Len42/Dexy/README.md

# Dexy

_DX7-inspired FM synthesis with a Raspberry Pi Pico_

Dexy is a digital FM voice in a 10 HP module. Part of my [homebrew Eurorack synthesizer](https://lenp.net/synth/).

[See here](https://lenp.net/synth/dexy/) for more info.

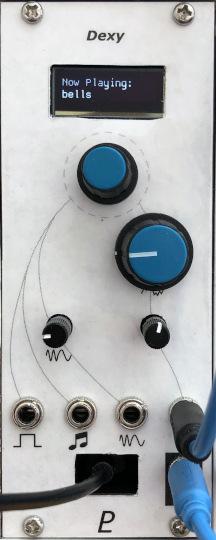
[picture p1: Dexy.jpg]
