Len42/Dexy/hardware/README.md

# Dexy Hardware

Dexy is a digital FM voice module based on an [RP2040 microcontroller](https://www.raspberrypi.com/documentation/microcontrollers/rp2040.html).

[See here](https://lenp.net/synth/dexy/hardware.html) for more info.

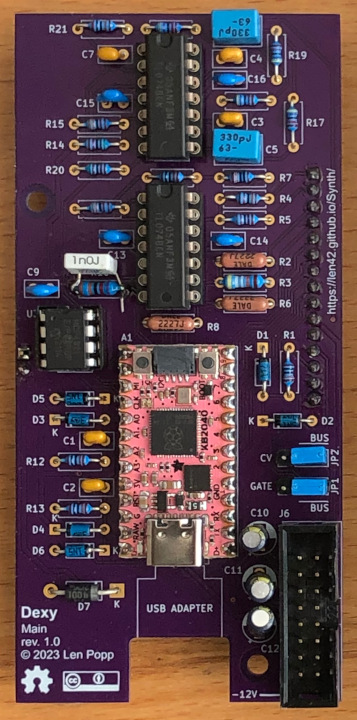
[picture p2: hardware/board.jpg]

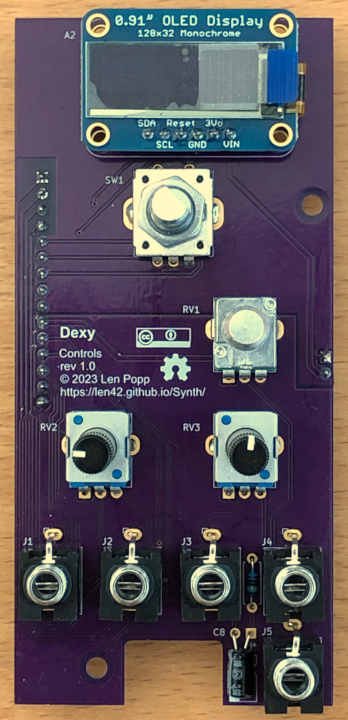
[picture p3: hardware/board2.jpg]
