Len42/Dexy/firmware/README.md

# Dexy Firmware

Firmware for the Dexy FM voice module.

[See here](https://lenp.net/synth/dexy/firmware.html) for more info.

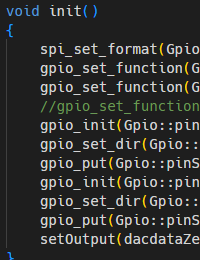
[picture p4: firmware/firmware.png]
