Len42/Dexy/software/DexyPatch/README.md

# DexyPatch Software

DexyPatch is a Windows application for editing patches for the Dexy module.

[See here](https://lenp.net/synth/dexy/software.html) for more info.

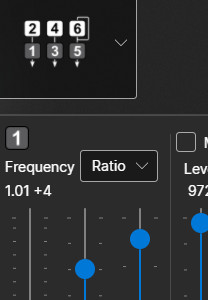
[picture p5: software/DexyPatch/software.jpg]
