Len42/Dexy/software/ConvertAlgoData/README.md

# ConvertAlgoData

This is a utility program to convert the definitions of the DX7 FM synthesis
algorithms from C++ (for the firmware) to C# (for the DexyPatch software).

<hr /><div><div style="xfloat:left; padding-left:10px;"><br />© 2023 Len Popp CC BY<br />This work is licensed under a <a rel="license" href="http://creativecommons.org/licenses/by/4.0/">Creative Commons Attribution 4.0 International License</a>.</div></div>
