Len42/Dexy/hardware/schematic2.png

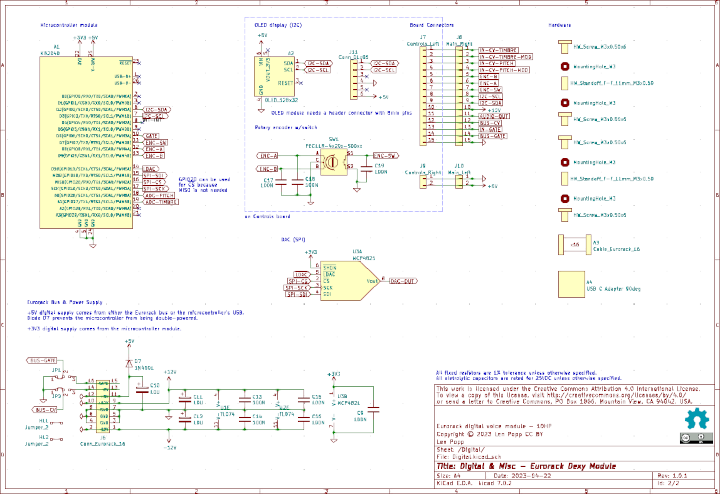
hardware/schematic2.png
