Len42/Dexy/hardware/schematic.png

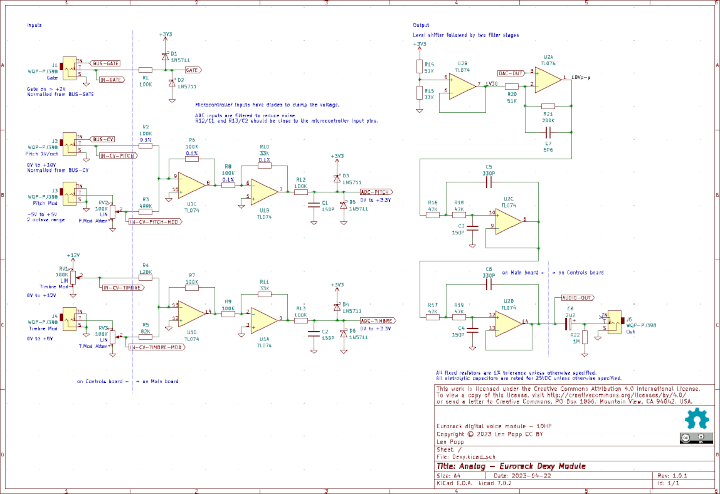
hardware/schematic.png
