Len42/Dexy/software/DexyPatch/DexyPatch/Assets/algorithms/algo-1.png

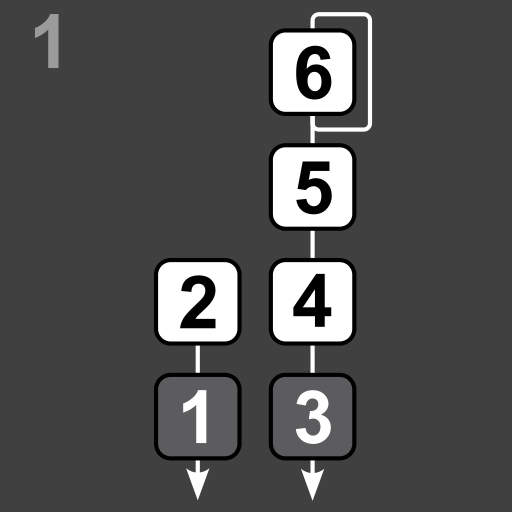
software/DexyPatch/DexyPatch/Assets/algorithms/algo-1.png
