Len42/Dexy/software/DexyPatch/DexyPatch/Assets/algorithms/algo-3.png

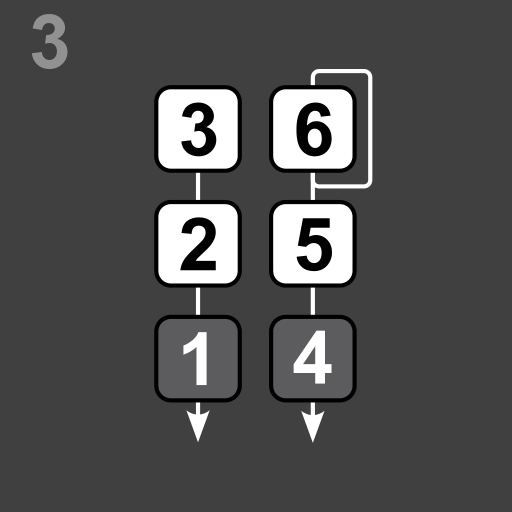
software/DexyPatch/DexyPatch/Assets/algorithms/algo-3.png
