Len42/Dexy/software/DexyPatch/DexyPatch/Assets/algorithms/algo-5.png

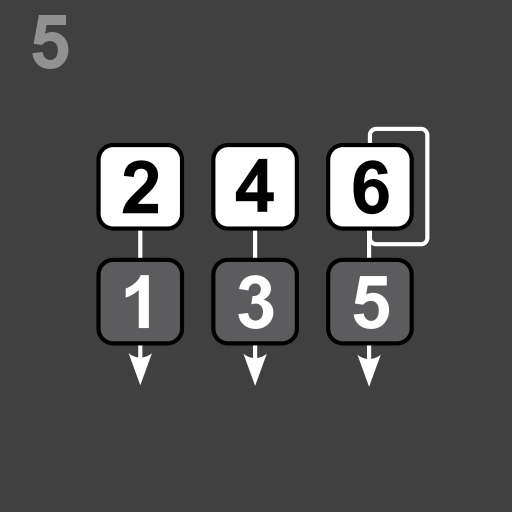
software/DexyPatch/DexyPatch/Assets/algorithms/algo-5.png
