Len42/Dexy/software/DexyPatch/DexyPatch/Assets/algorithms/algo-7.png

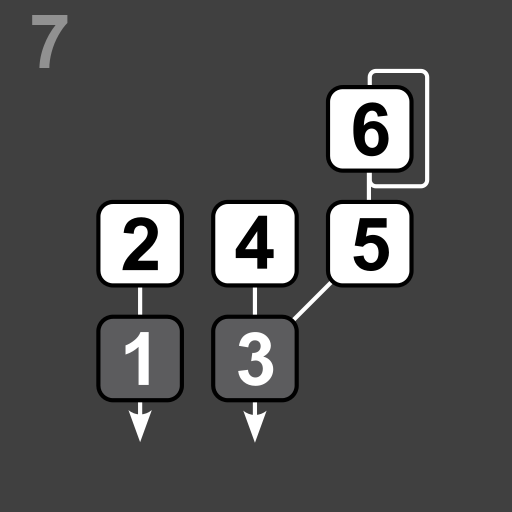
software/DexyPatch/DexyPatch/Assets/algorithms/algo-7.png
