Len42/Dexy/software/DexyPatch/DexyPatch/Assets/algorithms/algo-10.png

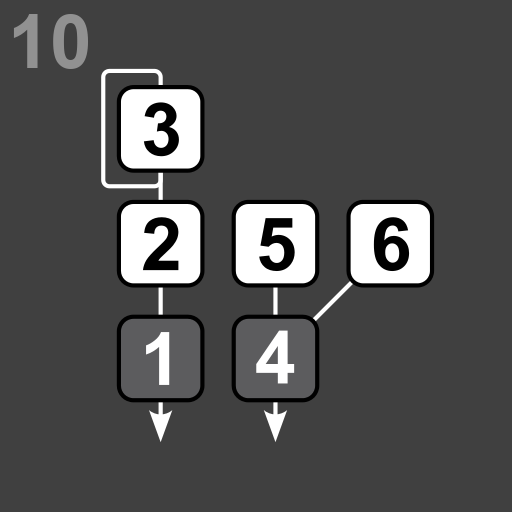
software/DexyPatch/DexyPatch/Assets/algorithms/algo-10.png
