Len42/Dexy/software/DexyPatch/DexyPatch/Assets/algorithms/algo-11.png

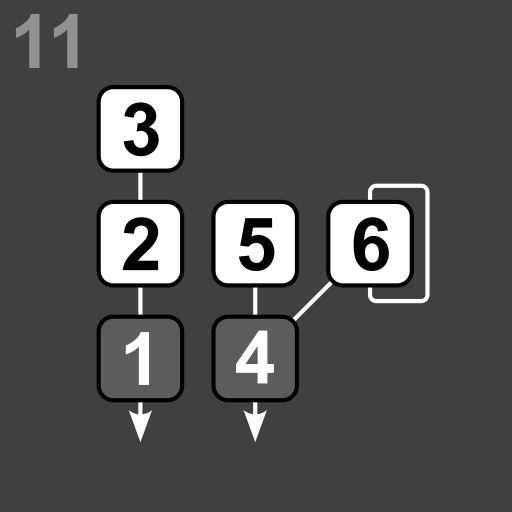
software/DexyPatch/DexyPatch/Assets/algorithms/algo-11.png
