Len42/Dexy/software/DexyPatch/DexyPatch/Assets/algorithms/algo-12.png

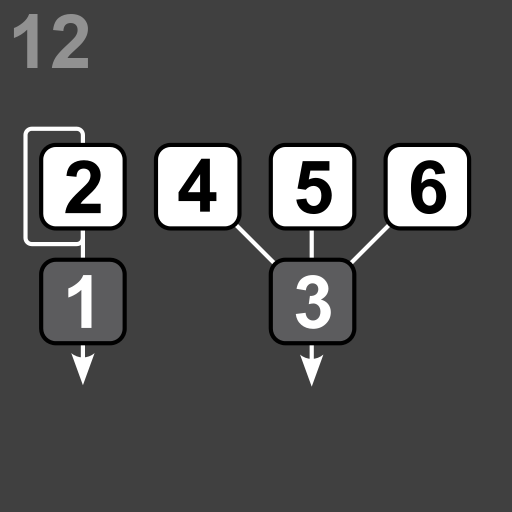
software/DexyPatch/DexyPatch/Assets/algorithms/algo-12.png
