Len42/Dexy/software/DexyPatch/DexyPatch/Assets/algorithms/algo-16.png

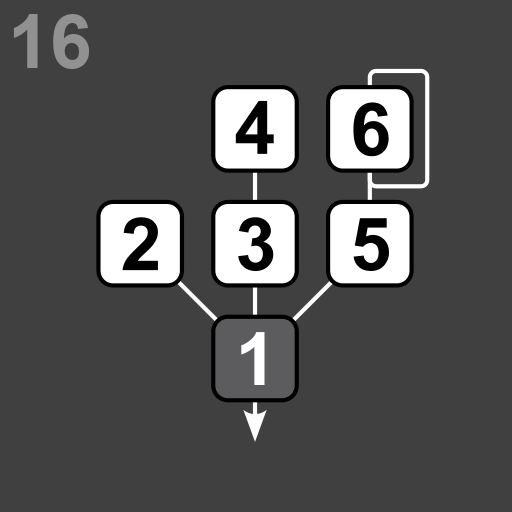
software/DexyPatch/DexyPatch/Assets/algorithms/algo-16.png
