Len42/Dexy/software/DexyPatch/DexyPatch/Assets/algorithms/algo-18.png

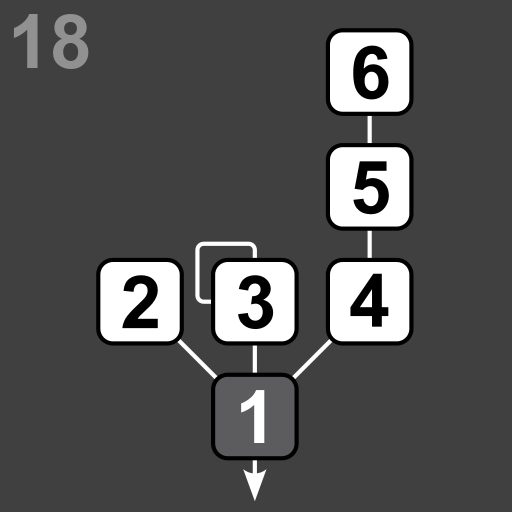
software/DexyPatch/DexyPatch/Assets/algorithms/algo-18.png
