Len42/Dexy/software/DexyPatch/DexyPatch/Assets/algorithms/algo-19.png

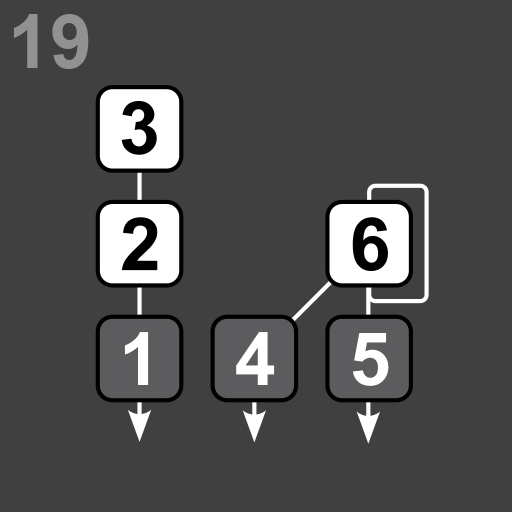
software/DexyPatch/DexyPatch/Assets/algorithms/algo-19.png
