Len42/Dexy/software/DexyPatch/DexyPatch/Assets/algorithms/algo-21.png

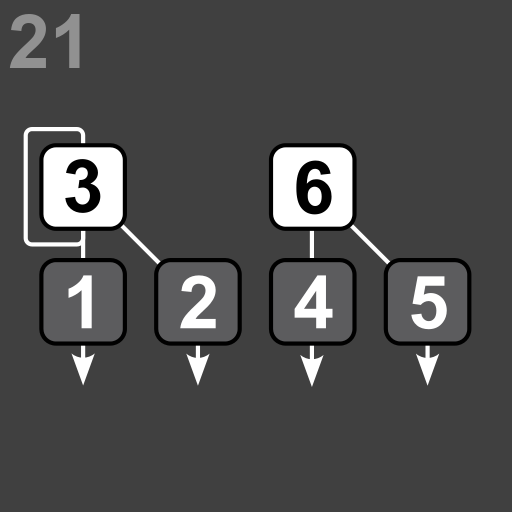
software/DexyPatch/DexyPatch/Assets/algorithms/algo-21.png
