Len42/Dexy/software/DexyPatch/DexyPatch/Assets/algorithms/algo-23.png

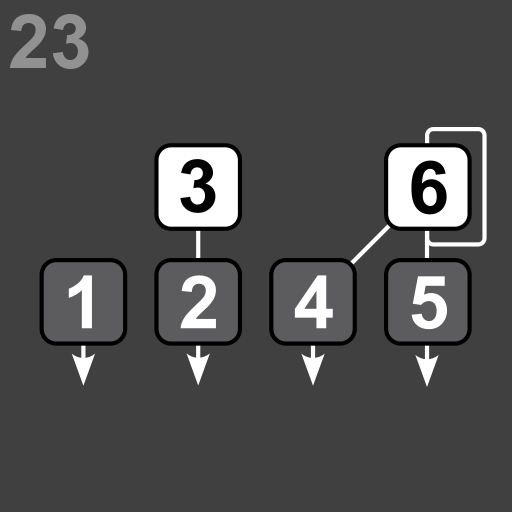
software/DexyPatch/DexyPatch/Assets/algorithms/algo-23.png
