Len42/Dexy/software/DexyPatch/DexyPatch/Assets/algorithms/algo-24.png

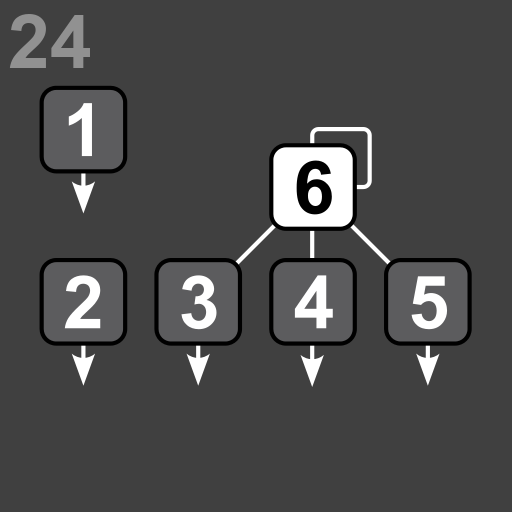
software/DexyPatch/DexyPatch/Assets/algorithms/algo-24.png
