Len42/Dexy/software/DexyPatch/DexyPatch/Assets/algorithms/algo-25.png

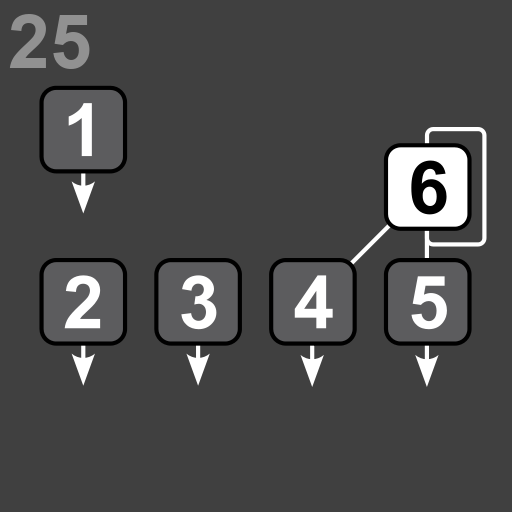
software/DexyPatch/DexyPatch/Assets/algorithms/algo-25.png
