Len42/Dexy/software/DexyPatch/DexyPatch/Assets/algorithms/algo-26.png

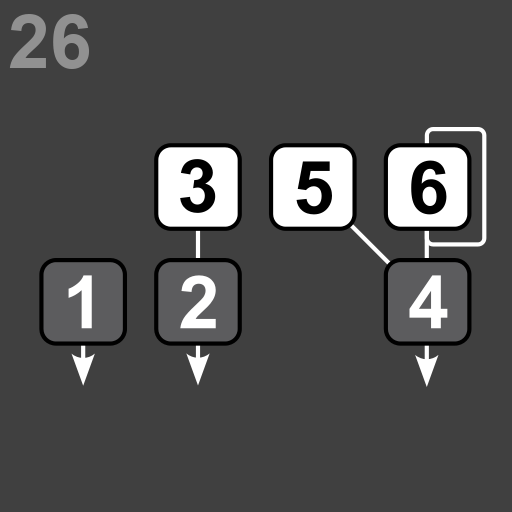
software/DexyPatch/DexyPatch/Assets/algorithms/algo-26.png
