Len42/Dexy/software/DexyPatch/DexyPatch/Assets/algorithms/algo-28.png

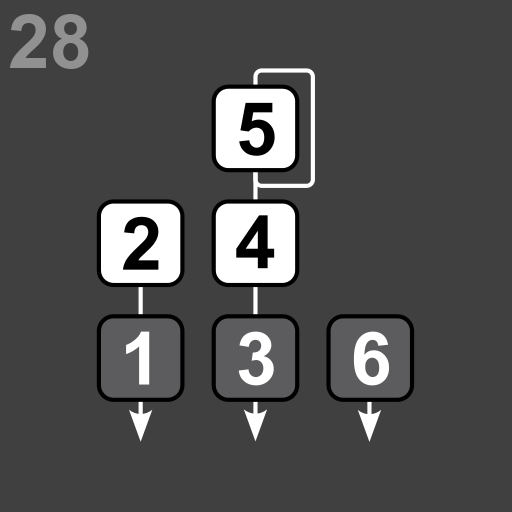
software/DexyPatch/DexyPatch/Assets/algorithms/algo-28.png
