Len42/Dexy/software/DexyPatch/DexyPatch/Assets/algorithms/algo-29.png

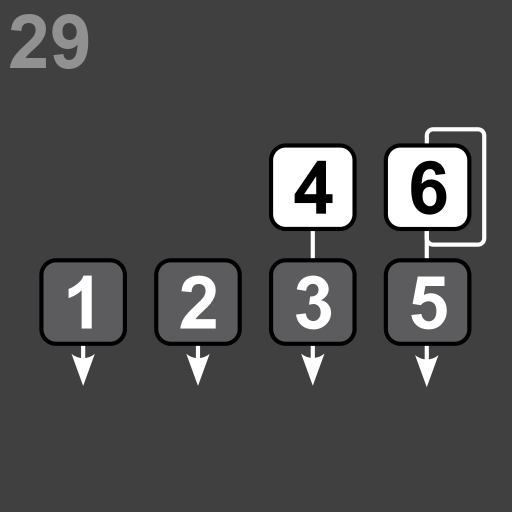
software/DexyPatch/DexyPatch/Assets/algorithms/algo-29.png
