Len42/Dexy/software/DexyPatch/DexyPatch/Assets/algorithms/algo-30.png

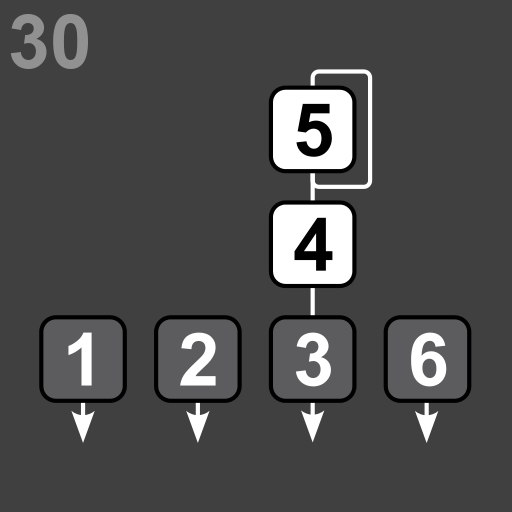
software/DexyPatch/DexyPatch/Assets/algorithms/algo-30.png
