Len42/Dexy/software/DexyPatch/DexyPatch/Assets/algorithms/algo-31.png

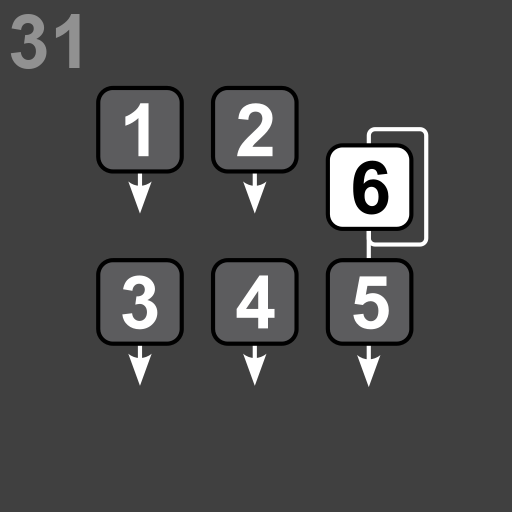
software/DexyPatch/DexyPatch/Assets/algorithms/algo-31.png
