Len42/Dexy/software/DexyPatch/screen.jpg

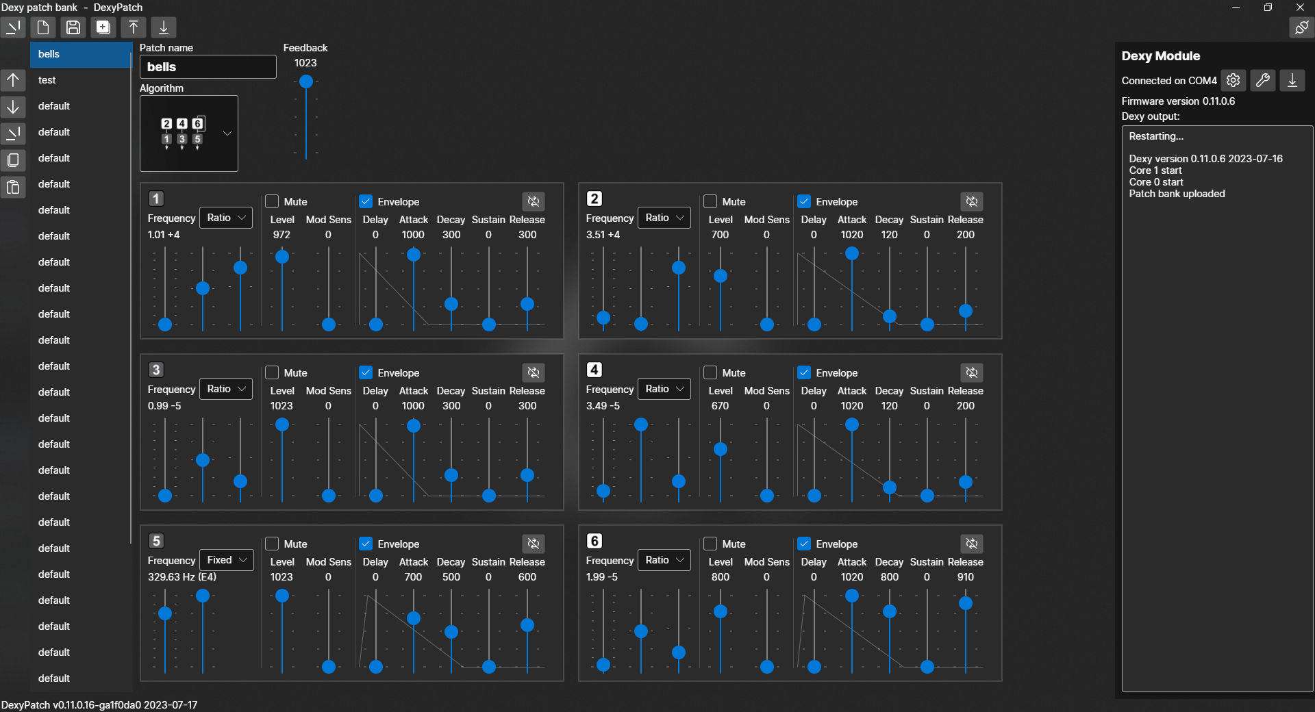
software/DexyPatch/screen.jpg
