Len42/Dexy/hardware/schematic.pdf

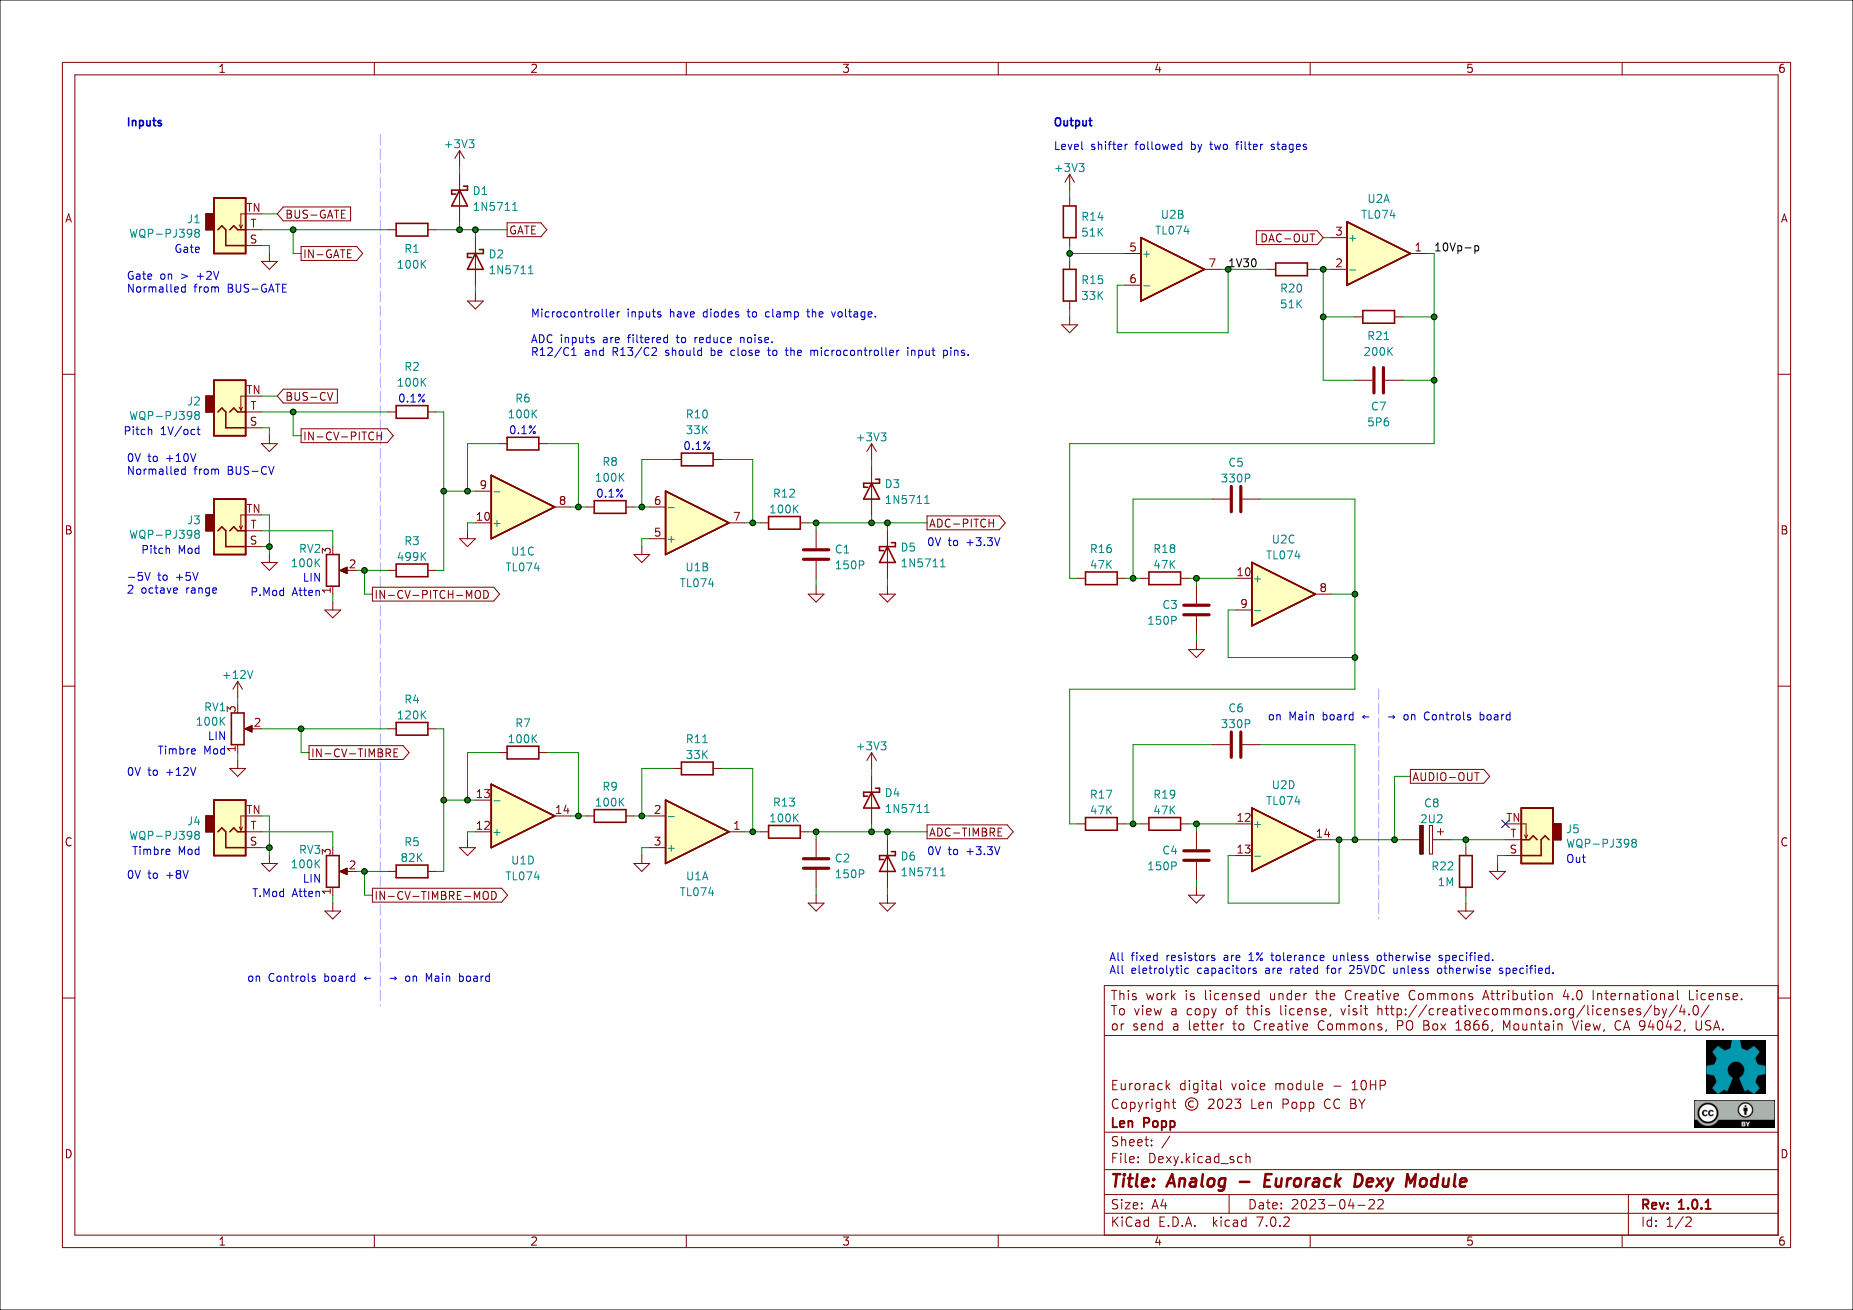
[picture p28: page 1]

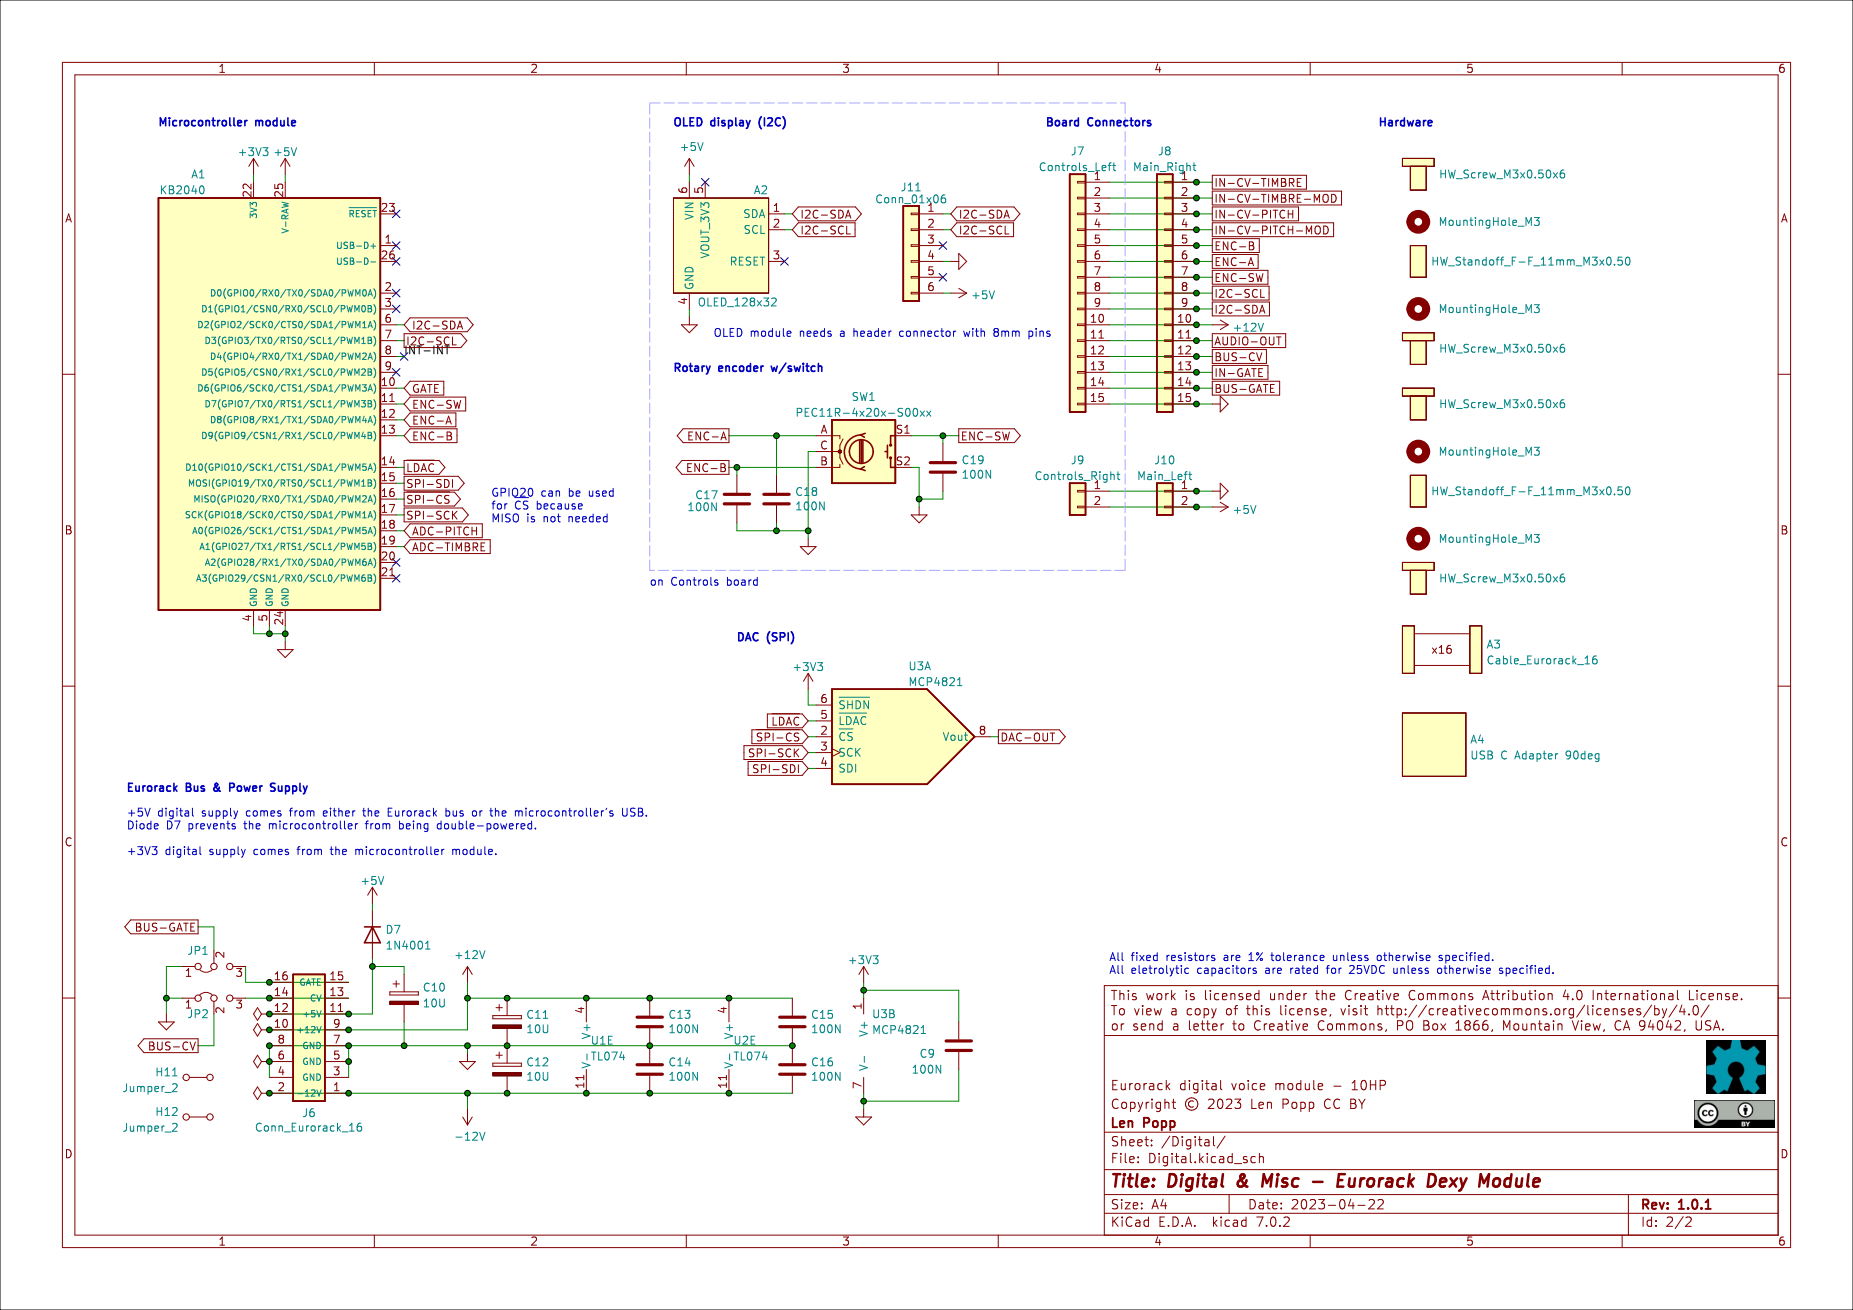
[picture p29: page 2]
