Len42/Dexy/hardware/Dexy.kicad_pcb

## KiCad design hardware/Dexy.kicad_pcb (2024-08-08)

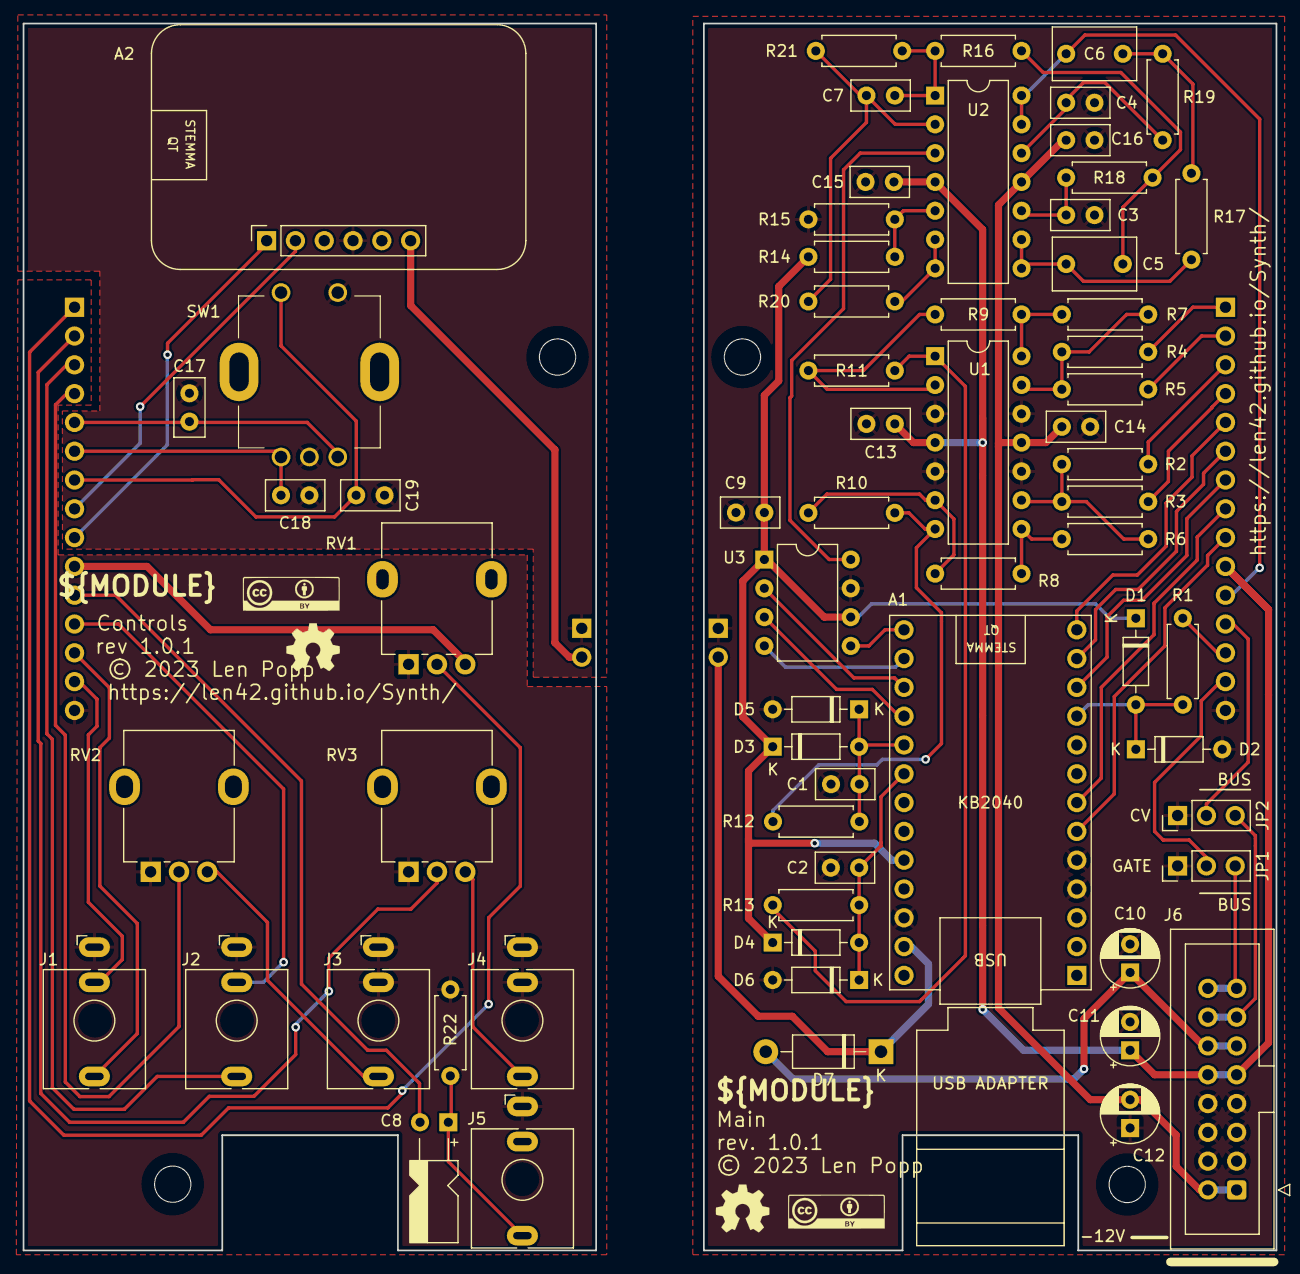
[picture p30: board Dexy.kicad_pcb from above]

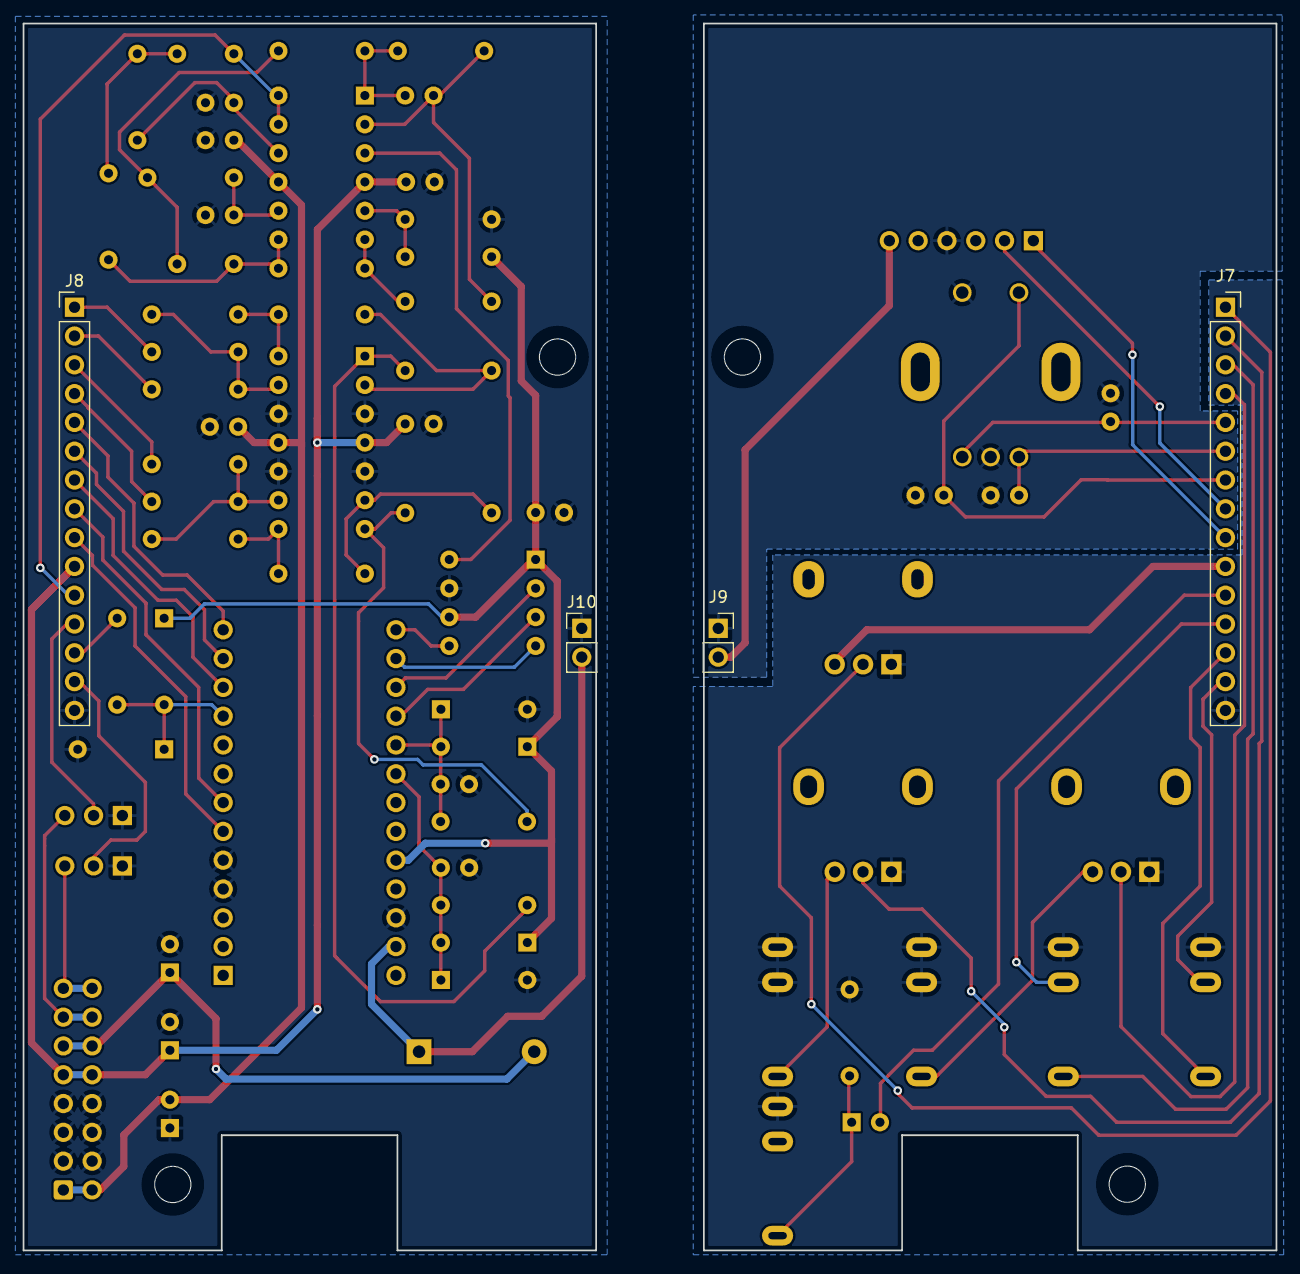
[picture p31: board Dexy.kicad_pcb from below]

Board: 2 copper layers, 110.5 x 108.2 mm, 78 parts (4 on the bottom side), 49 nets.

Parts:
A1: KB2040
A2: OLED_128x32; OLED_128x32_0.91in_NoHoles
A4: USB C Adapter 90deg; USB-C-Adapter-90-Outline
C1, C2, C3, C4: 150P; C_Disc_D5.0mm_W2.5mm_P2.50mm
C5, C6: 330P; C_Rect_L7.2mm_W4.5mm_P5.00mm
C7: 5P6; C_Disc_D5.0mm_W2.5mm_P2.50mm
C8: 2U2; CP_Radial_L7.0mm_D4.0mm_P2.50mm_Horiz
C9, C13, C14, C15, C16, C17, C18, C19: 100N; C_Disc_D5.0mm_W2.5mm_P2.50mm
C10, C11, C12: 10U; CP_Radial_D5.0mm_P2.50mm
D1, D2, D3, D4, D5, D6: 1N5711; D_DO-35_SOD27_P7.62mm_Horizontal
D7: 1N4001; D_DO-41_SOD81_P10.16mm_Horizontal
G1, G2: LOGO; Logo_CC_BY
G3, G4: LOGO; Logo_OSHW
H1, H2, H3, H4: MountingHole_M3; MountingHole_PCB_3.2mm_M3
J1, J2, J3, J4, J5: WQP-PJ398; Jack_3.5mm_QingPu_WQP-PJ398SM_Vertical
J6: Conn_Eurorack_16; IDC-Header-Eurorack-16-TH
J7: Controls_Left; PinSocket_1x15_P2.54mm_Vertical
J8: Main_Right; PinHeader_1x15_P2.54mm_Vertical
J9: Controls_Right; PinSocket_1x02_P2.54mm_Vertical
J10: Main_Left; PinHeader_1x02_P2.54mm_Vertical
JP1, JP2: Jumper_Pins_3_Bridged12; PinHeader_1x03_P2.54mm_Vertical
R1, R2, R6, R7, R8, R9, R12, R13: 100K; R_Axial_DIN0207_L6.3mm_D2.5mm_P7.62mm_Horizontal
R3: 499K; R_Axial_DIN0207_L6.3mm_D2.5mm_P7.62mm_Horizontal
R4: 120K; R_Axial_DIN0207_L6.3mm_D2.5mm_P7.62mm_Horizontal
R5: 82K; R_Axial_DIN0207_L6.3mm_D2.5mm_P7.62mm_Horizontal
R10, R11, R15: 33K; R_Axial_DIN0207_L6.3mm_D2.5mm_P7.62mm_Horizontal
R14, R20: 51K; R_Axial_DIN0207_L6.3mm_D2.5mm_P7.62mm_Horizontal
R16, R17, R18, R19: 47K; R_Axial_DIN0207_L6.3mm_D2.5mm_P7.62mm_Horizontal
R21: 200K; R_Axial_DIN0207_L6.3mm_D2.5mm_P7.62mm_Horizontal
R22: 1M; R_Axial_DIN0207_L6.3mm_D2.5mm_P7.62mm_Horizontal
RV1: 100K; Potentiometer_Alpha_RD901F-40-00D_Single_Vertical
RV2, RV3: 100K; Potentiometer_SongHuei_Single_Vertical
SW1: PEC11R-4x20x-S00xx; Encoder_Bourns_PEC11R_Switch
U1, U2: TL074; DIP-14_W7.62mm
U3: MCP4821; DIP-8_W7.62mm

Connections:
+3V3: A1.22 (3V3), C9.2, D1.1 (K), D3.1 (K), D4.1 (K), R14.1, U3.1 (V+), U3.6 (~SHDN)
+5V: A1.25 (V-RAW), A2.6 (VIN), D7.1 (K), J9.2, J10.2
+12V: C11.1, C13.1, C15.1, J6.9 (+12V), J6.10, J7.10, J8.10, RV1.3, U1.4 (V+), U2.4 (V+)
-12V: C12.2, C14.2, C16.2, J6.1 (-12V), J6.2, U1.11 (V-), U2.11 (V-)
/1V30: R20.1, U2.6 (-), U2.7
/10Vp-p: C7.2, R16.1, R21.2, U2.1
ADC-PITCH: A1.18 (A0(GPIO26/SCK1/CTS1/SDA1/PWM5A)), C1.1, D3.2 (A), D5.1 (K), R12.2
ADC-TIMBRE: A1.19 (A1(GPIO27/TX1/RTS1/SCL1/PWM5B)), C2.1, D4.2 (A), D6.1 (K), R13.2
AUDIO-OUT: C6.2, C8.2, J7.11, J8.11, U2.13 (-), U2.14
BUS-CV: J2.TN, J7.12, J8.12, JP2.2 (C)
BUS-GATE: J1.TN, J7.14, J8.14, JP1.2 (C)
DAC-OUT: U2.3 (+), U3.8 (Vout)
ENC-A: A1.12 (D8(GPIO8/RX1/TX1/SDA0/PWM4A)), C18.1, J7.6, J8.6, SW1.A
ENC-B: A1.13 (D9(GPIO9/CSN1/RX1/SCL0/PWM4B)), C17.1, J7.5, J8.5, SW1.B
ENC-SW: A1.11 (D7(GPIO7/TX0/RTS1/SCL1/PWM3B)), C19.1, J7.7, J8.7, SW1.S1
GATE: A1.10 (D6(GPIO6/SCK0/CTS1/SDA1/PWM3A)), D1.2 (A), D2.1 (K), R1.2
GND: A1.4 (GND), A1.5 (GND), A1.24 (GND), A2.4 (GND), C1.2, C2.2, C3.2, C4.2, C9.1, C10.2, C11.2, C12.1, C13.2, C14.1, C15.2, C16.1, C17.2, C18.2, C19.2, D2.2 (A), D5.2 (A), D6.2 (A), J1.S, J2.S, J3.S, J3.TN, J4.S, J4.TN, J5.S, J6.3 (GND), J6.4, J6.5 (GND), J6.6, J6.7 (GND), J6.8, J7.15, J8.15, J9.1, J10.1, JP1.1 (A), JP2.1 (A), R15.2, R22.2, RV1.1, RV2.1, RV3.1, SW1.C, SW1.S2, U1.3 (+), U1.5 (+), U1.10 (+), U1.12 (+), U3.7 (V-)
I2C-SCL: A1.7 (D3(GPIO3/TX0/RTS0/SCL1/PWM1B)), A2.2 (SCL), J7.8, J8.8
I2C-SDA: A1.6 (D2(GPIO2/SCK0/CTS0/SDA1/PWM1A)), A2.1 (SDA), J7.9, J8.9
IN-CV-PITCH: J2.T, J7.3, J8.3, R2.1
IN-CV-PITCH-MOD: J7.4, J8.4, R3.1, RV2.2
IN-CV-TIMBRE: J7.1, J8.1, R4.1, RV1.2
IN-CV-TIMBRE-MOD: J7.2, J8.2, R5.1, RV3.2
IN-GATE: J1.T, J7.13, J8.13, R1.1
unnamed: C5.1, R16.2, R18.1
unnamed: C6.1, R17.2, R19.1
unnamed: C8.1, J5.T, R22.1
unnamed: C10.1, D7.2 (A), J6.11 (+5V), J6.12
unnamed: J3.T, RV2.3
unnamed: J4.T, RV3.3
unnamed: J6.13 (CV), J6.14, JP2.3 (B)
unnamed: J6.15 (GATE), J6.16, JP1.3 (B)
unnamed: R6.2, R8.1, U1.8
unnamed: R7.2, R9.1, U1.14
unnamed: R10.2, R12.1, U1.7
unnamed: R11.2, R13.1, U1.1
unnamed: R9.2, R11.1, U1.2 (-)
unnamed: R8.2, R10.1, U1.6 (-)
unnamed: R2.2, R3.2, R6.1, U1.9 (-)
unnamed: R4.2, R5.2, R7.1, U1.13 (-)
unnamed: C7.1, R20.2, R21.1, U2.2 (-)
unnamed: R14.2, R15.1, U2.5 (+)
unnamed: C3.1, R18.2, U2.10 (+)
unnamed: C5.2, R17.1, U2.8, U2.9 (-)
unnamed: C4.1, R19.2, U2.12 (+)
SPI-SCK: A1.17 (SCK(GPIO18/SCK0/CTS0/SDA1/PWM1A)), U3.3 (SCK)
SPI-SDI: A1.15 (MOSI(GPIO19/TX0/RTS0/SCL1/PWM1B)), U3.4 (SDI)
~LDAC: A1.14 (D10(GPIO10/SCK1/CTS1/SDA1/PWM5A)), U3.5 (~LDAC)
~SPI-CS: A1.16 (MISO(GPIO20/RX0/TX1/SDA0/PWM2A)), U3.2 (~CS)
