Len42/Dexy/software/PatchDump/main.cpp

// PatchDump.cpp : This file contains the 'main' function. Program execution begins and ends there.
//

#include <iostream>
#include <fstream>
#include <string>
#include <string_view>
#include <format>
#include <vector>
#include <variant>
#include <ranges>
#include <concepts>
#include <exception>
#include <cmath>

// Definitions for CmdLine.h
//#define CMDLINE_PROG_NAME "patchdump"
#define CMDLINE_PROG_DESCRIPTION "Dump a Dexy patchbank file in text format"
#define CMDLINE_ALLOW_ARGS true
#define CMDLINE_ARGS_DESCRIPTION "Dexy patchbank file (default stdin)"
#define CMDLINE_OPTIONS(ITEM) \
    ITEM(ShowVersion, v, ver, bool, false, "Display the software version at startup") \
    ITEM(Debug, d, debug, bool, false, "Display debugging info")
#include "CmdLine.h"
#include "Banner.h"
#include "zpp_bits.h"

// header files from firmware
#include "Defs.h"
#include "Patches1.h"

using PatchBank = std::variant<Dexy::Patches::V1::PatchBank, /*DEBUG*/int>;

// Patch file header fields
using cookie_t = uint32_t;
constexpr cookie_t serializeCookie = 'D'|('e'|('x'|('y'<<8))<<8)<<8; // little-endian
using version_t = uint16_t;
constexpr version_t versionMax = 2; // DEBUG 1;
constexpr size_t serializeHdrSize = sizeof(serializeCookie) + sizeof(version_t);

// Maximum file size, based on the largest version of serialized patch data
constexpr size_t maxFileSize = serializeHdrSize + Dexy::Patches::V1::patchBankSize;

static std::string inputFileName;

// DPRINT - Print output only if the debug flag is set
#define DPRINT(msg, ...) \
    if (CommandLine::GetDebug()) { \
        std::cout << std::format(msg, __VA_ARGS__) << '\n'; \
    }

[[noreturn]] static void throwError(const char* message)
{
    throw std::runtime_error(message);
}

[[noreturn]] static void throwFileError(const char* message)
{
    throwError(std::format("{} {}", message, inputFileName).c_str());
}

static std::string_view TrimBlanks(std::string_view str)
{
    size_t start = str.find_first_not_of(" ");
    if (start == std::string_view::npos) {
        return std::string_view();
    } else {
        str.remove_prefix(start);
        size_t end = str.find_last_not_of(" ");
        if (end != std::string_view::npos) {
            str.remove_suffix(str.length() - end - 1);
        }
        return str;
    }
}

static auto ReadFile(std::istream& input)
{
    // Read one more byte than the max necessary, to check for eof.
    std::vector<char> storage(maxFileSize + 1);
    input.read(storage.data(), maxFileSize + 1);
    size_t numRead = input.gcount();
    DPRINT("ReadFile: numRead={}", numRead);
    if (numRead > maxFileSize) {
        throwFileError("Bad patch file length");
    }
    storage.resize(numRead);
    return storage;
}

static version_t CheckHeader(auto& in)
{
    cookie_t cookie;
    version_t version;
    in(cookie, version).or_throw();
    DPRINT("CheckHeader: cookie={:x} version={}", cookie, version);
    if (cookie != serializeCookie) {
        throwFileError("Bad patch file header");
    }
    if (version == 0 || version > versionMax) {
        throwFileError("Bad patch file version");
    }
    return version;
}

/// <summary>
/// Apply a function to each operator in a patch, in display order.
/// </summary>
/// <remarks>
/// Use this instead of a "for" loop because the display order for the operators
/// is the reverse of the storage order (for historical reasons).
/// </remarks>
template<class PATCH, class OP>
static void DoAllOps(std::ostream& output, const PATCH& patch, auto func)
{
    for (const OP& op : patch.opParams | std::views::reverse) {
        func(output, op);
    }
}

static auto LoadPatchBank(auto storage)
{
    try {
        PatchBank patchBank;
        zpp::bits::in in(storage);
        version_t version = CheckHeader(in);
        switch (version) {
        case 1:
            patchBank = Dexy::Patches::V1::PatchBank();
            in(std::get<Dexy::Patches::V1::PatchBank>(patchBank)).or_throw();
            break;
        case 2:
            patchBank = int();
            in(std::get<int>(patchBank)).or_throw();
            break;
        default:
            throwFileError("Unrecognized patchbank version");
        }
        DPRINT("LoadPatchBank: Read patchbank version={}", version);
        // There should be no data left in the file
        if (!in.remaining_data().empty()) {
            throwFileError("Bad patch file length");
        }
        return std::pair{ version, patchBank };
    } catch (std::system_error& ex) {
        // Improve the error messages from zpp::bits
        // TODO: don't format - just "Bad patch file contents" is fine
        std::string msg = std::format("Bad patch file contents ({}) -", ex.what());
        throwFileError(msg.c_str());
    }
}

template<class PATCH, class OP>
static void DumpOpField(std::ostream& output, const PATCH& patch,
                        std::string_view name, auto OP::* pfield)
{
    output << name;
    DoAllOps<PATCH, OP>(output, patch,
        [pfield](auto&& output, auto&& op)
            { output << std::format(",{}", op.*pfield); });
    output << '\n';
}

template<class PATCH, class OP, class SUB>
static void DumpOpField(std::ostream& output, const PATCH& patch,
                        std::string_view name, SUB OP::* psub, auto SUB::* pfield)
{
    output << name;
    DoAllOps<PATCH, OP>(output, patch,
        [pfield, psub](auto&& output, auto&& op)
            { output << std::format(",{}", op.*psub.*pfield); });
    output << '\n';
}

static std::string NoteToName(Dexy::midiNote_t midiNote)
{
    int noteNum = midiNote / 256;
    int frac = midiNote % 256;
    if (frac > 127) {
        ++noteNum;
        frac -= 256;
    } else if (frac < -127) {
        --noteNum;
        frac += 256;
    }
    int octave = noteNum / 12 - 1;
    int note = noteNum % 12;
    if (note < 0) {
        note += 12;
    }
    int cents = (int)((double)frac * 100 / Dexy::midiNoteSemitone);
    static constexpr std::string_view noteNames[] = {
      "C"sv,"C♯"sv,"D"sv,"E♭"sv,"E"sv,"F"sv,"F♯"sv,"G"sv,"G♯"sv,"A"sv,"B♭"sv,"B"sv
    };
    std::string_view noteName = noteNames[note];
    if (cents == 0) {
        return std::format("{}{}", noteName, octave);
    } else {
        return std::format("{}{}{:+}", noteName, octave, cents);
    }
}

static double NoteToHz(Dexy::midiNote_t midiNote)
{
    return 440 * std::exp2(((double)midiNote / 256 - 69) / 12);
}

static std::string NoteToHzString(Dexy::midiNote_t midiNote)
{
    return std::format("{:.4}Hz", NoteToHz(midiNote)); // TODO: format?
}

static std::string NoteToString(Dexy::midiNote_t midiNote)
{
    if (midiNote >= 12 * Dexy::midiNoteSemitone) {
        return NoteToName(midiNote);
    } else {
        return NoteToHzString(midiNote);
    }
}

static void DumpPatch(std::ostream& output,
                      const Dexy::Patches::V1::Patch& patch)
{
    using namespace Dexy::Patches::V1;
    output << std::format("Patch,\"{}\"\n",
        TrimBlanks(std::string_view(std::begin(patch.name), std::end(patch.name))));
    output << std::format("Algorithm,{}\n", patch.algorithm + 1);
    output << std::format("Feedback,{}\n", patch.feedbackAmount);
    // Display per-operator fields in rows for readability
    DumpOpField(output, patch, "FixedFrequency", &OpParams::fixedFreq);
    // Smart display of MIDI note or frequency
    output << "RatioOrFrequency";
    DoAllOps<Patch, OpParams>(output, patch,
        [](auto&& output, auto&& op) {
            if (op.fixedFreq) {
                // Fixed pitch
                output << std::format(",{}",
                    NoteToString(Dexy::midiNote_t(op.noteOrFreq)));
            } else {
                // Frequency ratio
                output << std::format(",{:.4}",
                    double(Dexy::freqRatio_t(op.noteOrFreq)) / Dexy::freqRatio1);
            }
        });
    output << '\n';
    DumpOpField(output, patch, "OutputLevel", &OpParams::outputLevel);
    DumpOpField(output, patch, "UseEnvelope", &OpParams::useEnvelope);
    DumpOpField(output, patch, "AmpModSens", &OpParams::ampModSens);
    DumpOpField(output, patch, "EnvDelay", &OpParams::env, &EnvParams::delay);
    DumpOpField(output, patch, "EnvAttack", &OpParams::env, &EnvParams::attack);
    DumpOpField(output, patch, "EnvDecay", &OpParams::env, &EnvParams::decay);
    DumpOpField(output, patch, "EnvSustain", &OpParams::env, &EnvParams::sustain);
    DumpOpField(output, patch, "EnvRelease", &OpParams::env, &EnvParams::release);
    DumpOpField(output, patch, "EnvLoop", &OpParams::env, &EnvParams::loop);
}

static void DumpPatchBank(std::ostream& output,
                          const Dexy::Patches::V1::PatchBank& patchBank)
{
    DPRINT("DumpPatchBank: Dexy::Patches::V1::PatchBank");
    for (auto&& patch : patchBank.patches) {
        DumpPatch(output, patch);
    }
}

static void DumpPatchBank(std::ostream& output, int patchBank)
{
    DPRINT("DumpPatchBank: int");
    output << std::format("Bogus,{:x}\n", patchBank);
}

static void DumpPatchBankVar(std::ostream& output, const PatchBank& patchBank)
{
    std::visit([&](auto&& obj) { DumpPatchBank(output, obj); }, patchBank);
}

int main(int argc, char* argv[])
{
    try {
        if (CommandLine::Parse(argc, argv)) {
            return 0;
        }
        if (CommandLine::GetShowVersion()) {
            PrintBanner();
        }

        // Open the input file
        bool inputFromStdin = false;
        std::ifstream inFile;
        auto args = CommandLine::GetOtherArgs();
        if (args.size() == 0) {
            inputFromStdin = true;
            inputFileName = "stdin";
        } else if (args.size() == 1) {
            inputFromStdin = false;
            inputFileName = args.front();
            inFile.open(inputFileName, std::ios::in | std::ios::binary);
            if (inFile.fail()) {
                throwFileError("Failed to open file");
            }
        } else {
            throwError("Too many file names");
        }
        std::istream& input = inputFromStdin ? std::cin : inFile;
        input.exceptions(std::istream::badbit); // Throw an exception on stream error

        std::ostream& output = std::cout;
        output << "Field,Value1,Value2,Value3,Value4,Value5,Value6\n";
        output << std::format("File,\"{}\"\n", inputFileName);

        auto storage = ReadFile(input);

        auto [version, patchBank] = LoadPatchBank(storage);

        output << std::format("Version,{}\n", version);

        DumpPatchBankVar(output, patchBank);

        return 0;
    } catch (const std::exception& ex) {
        std::cerr << std::format("{}: ERROR: {}\n",
            CommandLine::GetProgName(), ex.what());
        return 1;
    }
}
