Len42/Dexy/firmware/Tasks.h

#pragma once

namespace Dexy {
    
/// @brief A simple, efficient task scheduler for embedded microcontrollers
///
/// This task scheduler is designed to be simple to use and to have very little
/// overhead in time and memory. Some compile-time tricks are used to create a
/// static list of tasks, while keeping the application-level code simple with
/// a minimum of boilerplate.
/// 
/// Usage
/// -----
/// To define a set of tasks:
/// 
/// 1. Define each task as a subclass of Tasks::Task like this.
/// A single instance of this class will be created automatically.
/// @code
/// class ExampleTask : public Tasks::Task
/// {
/// public:
///     // Task execution interval in microseconds
///     unsigned intervalMicros() const override { return 1'000'000; }
/// 
///     // Task initialization, called once at program start
///     void init() override
///     {
///         // task initialization code
///     }
/// 
///     // Main task function, executed at (approximately) the specified interval
///     void execute() override
///     {
///         // task main code
///     }
/// };
/// @endcode
/// 2. Make a list of all the tasks by declaring a Tasks::TaskList.
/// Any tasks not currently required (e.g. for debugging) can be commented out
/// and the unused task code will not be compiled into the executable.
/// @code
/// constexpr Tasks::TaskList<
///     ExampleTask,
///     AnotherTask,
///     AndAnotherTask
/// > taskList;
/// @endcode
/// 3. In main(), initialize all the tasks and then execute them repeatedly.
/// @code
/// int main()
/// {
///     // Initialize all the tasks.
///     taskList.initAll();
///
///     // Execute all the tasks repeatedly, at their specified time intervals.
///     while (true) {
///         taskList.runAll();
///     }
///
///     return 0;
/// }
/// @endcode
///
/// Acknowledgements
/// ----------------
/// Thanks to Luke Valenty for the slideware: https://youtu.be/fk0ihqOXER8

namespace Tasks {

/// @brief  Base class for application-defined tasks
class Task
{
public:
    /// @brief How often this task should be executed
    /// @return Task execution interval in microseconds
    virtual unsigned intervalMicros() const = 0;

    /// @brief Task initialization, called once at program start
    virtual void init() = 0;

    /// @brief Main task function, executed at approximately the specified interval
    virtual void execute() = 0;

    /// @brief If it's time to call execute(), do so
    /// @param now Current time
    void tick(absolute_time_t now)
    {
        if (timeIsReached(now, timer)) {
            timer = make_timeout_time_us(intervalMicros());
            execute();
        }
    }

private:
    /// @brief Keeps track of the next time this task should be executed
    absolute_time_t timer = from_us_since_boot_constexpr(0);
};

/// @brief There is one static instance of each subclass of Task
/// @tparam TASK_T A subclass of Task
template<typename TASK_T>
static TASK_T taskInstance;

/// @brief A static list of Task that is initialized at compile time
/// @tparam ...TASKS List of Task subclasses
template<typename... TASKS>
class TaskList
{
public:
    consteval TaskList()
    {
        int i = 0;
        ((tasks[i++] = &taskInstance<TASKS>), ...);
    }

    /// @brief Initialize all the tasks
    IN_FLASH("Tasks")
    void initAll() const
    {
        for (auto&& task : tasks) {
            task->init();
        }
    };

    /// @brief Execute all the tasks repeatedly, at their specified time intervals
    IN_FLASH("Tasks")
    void runAll() const
    {
        absolute_time_t now = get_absolute_time();
        for (auto&& task : tasks) {
            task->tick(now);
        }
    };

private:
    /// @brief List of Task instances to be executed
    Task* tasks[sizeof...(TASKS)];
};

} } // namespace Tasks
