Len42/Dexy/firmware/Patches.cpp

namespace Dexy { namespace Patches {

/// @brief Is the given char valid for a patch name?
/// @details This is based on the set of characters that can be displayed.
/// @param ch 
/// @return Yes or no
static constexpr bool isGoodChar(char ch)
{
    // Any character >= ' ' can be displayed.
    // Don't allow null char. Patch name field must be blank-padded not 0-terminated.
    constexpr char charMin = 32;
    return ch >= charMin;
}

constexpr bool isValid(const EnvParams& obj)
{
    return obj.delay <= max_param_t
        && obj.attack <= max_param_t
        && obj.decay <= max_param_t
        && obj.sustain <= max_param_t
        && obj.release <= max_param_t;
}

constexpr bool isValid(const OpParams& obj)
{
    return obj.outputLevel <= max_param_t
        && obj.ampModSens <= max_param_t
        && isValid(obj.env);
}

constexpr bool isValid(const Patch& obj)
{
    return obj.algorithm < numAlgorithms
        && obj.feedbackAmount <= max_param_t
        && std::ranges::all_of(obj.name, [](auto&& ch){return isGoodChar(ch);})
        && std::ranges::all_of(obj.opParams, [](auto&& op) { return isValid(op); });
}

constexpr bool isValid(const PatchBank& obj)
{
    return std::ranges::all_of(obj.patches, [](auto&& patch){return isValid(patch);});
}

/// @brief Short consteval helper to serialize a PatchBank for initialization
/// @tparam patchBank 
/// @return 
template<PatchBank patchBank>
static consteval SerializedPatchBank patchBankToBytes()
{
    return Serialize::objToBytes<PatchBank, patchBank, patchBankDataSize>();
}

/// @brief The initial patch data that is loaded into the PatchBank at startup
/// @details Stored in flash memory with alignment and padding so it can be
/// over-written by the SDK flash programming API.
IN_FLASH("PatchData")
static constinit Flash::Wrapper<SerializedPatchBank> initialPatchData {
    #include "default.dexy.h" // #embed pls?
    // old: patchBankToBytes<makeDefaultPatchBank()>()
};

/// @brief The patch bank that is currently loaded
static PatchBank patchBankCurrent;

/// @brief Compile-time consistency checks
static consteval void verifyData()
{
    static_assert(isValid(makeDefaultPatchBank()));
    static_assert(patchBankDataSize == patchBankToBytes<makeDefaultPatchBank()>().size());
    static_assert((sizeof(Flash::Wrapper<SerializedPatchBank>) % 4096) == 0);
    constexpr PatchChange p{.iPatch=0, .patch={}};
    static_assert(patchChangeDataSize == Serialize::objToBytes<PatchChange, p, patchChangeDataSize>().size());
    constexpr PatchNameChange name{.iPatch=0, .name=""};
    static_assert(patchNameChangeDataSize == Serialize::objToBytes<PatchNameChange, name, patchNameChangeDataSize>().size());
    constexpr PatchSettingChange change1{.iPatch=0, .field=0, .value=0};
    static_assert(patchSettingChangeDataSize == Serialize::objToBytes<PatchSettingChange, change1, patchSettingChangeDataSize>().size());
    constexpr PatchOpChange change2{.iPatch=0, .iOp=0, .field=0, .value=0};
    static_assert(opParamsChangeDataSize == Serialize::objToBytes<PatchOpChange, change2, opParamsChangeDataSize>().size());
    static_assert((sizeof(Flash::Wrapper<SerializedPatchBank>) % 4096) == 0);
}

IN_FLASH("Patches")
void init()
{
    verifyData();

    // Initialize the patch bank from serialized storage
    Patches::loadCurrentPatchBank(initialPatchData.obj);
}

Patch& getPatch(unsigned i)
{
    if (i >= numPatches) {
        i = 0;
    }
    return patchBankCurrent.patches[i];
}

IN_FLASH("Patches")
bool loadCurrentPatchBank(const auto& storage)
{
    static PatchBank patchBankNew; // must be static because stack space is limited
    if (Serialize::readObject(storage, &patchBankNew)) {
        if (!isValid(patchBankNew)) {
            dputs("loadCurrentPatchBank: ERROR: Bad patch data");
            Error::set<Error::Err::BadPatchData>();
            return false;
        }
        patchBankCurrent = patchBankNew;
        return true;
    } else {
        return false;
    }
}

IN_FLASH("Patches")
size_t saveCurrentPatchBank(auto* pstorage)
{
    return Serialize::writeObject(*pstorage, patchBankCurrent);
}

IN_FLASH("Patches")
void saveInitialPatchData(const SerializedPatchBank& patchData)
{
    Flash::copyToFlash(patchData, &initialPatchData);
}

} } // namespace Patches
