Len42/Dexy/firmware/PicoSdk.h

// Include files for the Raspberry Pi Pico SDK

#pragma once

#include "pico/stdlib.h"
#include "pico/multicore.h"
#include "pico/sync.h"
#include "pico/bootrom.h"
#include "pico/binary_info.h"
#include "pico/stdio/driver.h"
#include "hardware/interp.h"
#include "hardware/spi.h"
#include "hardware/i2c.h"
#include "hardware/irq.h"
#include "hardware/pwm.h"
#include "hardware/adc.h"
#include "hardware/flash.h"
#include "hardware/watchdog.h"
