Len42/Dexy/(commit log)

2023-07-27 Firmware: Envelope tweaks (#2)
    fix envelope clicks
    [Envelope.cpp, Envelope.h]
2023-12-31 Firmware: fix a comment
    [DataTable.h]
2024-04-18 PatchDump: fix a couple of error messages
    [main.cpp]
2024-04-19 PatchDump: operator parameters printed in correct display order
    [main.cpp]
2024-08-08 hardware: PCB layout alignment changed to match template
    [Dexy.kicad_pcb, Dexy.kicad_sch, Digital.kicad_sch]
