Len42/Dexy/(notices)

Notices in the files:
hardware/panel/panel.kicad_sch:
Copyright © 2023 Len Popp CC BY
